AnatolyNevzoroff/SOLDERING_24V/FOTOBONUS/Front panel assembly 2.jpg

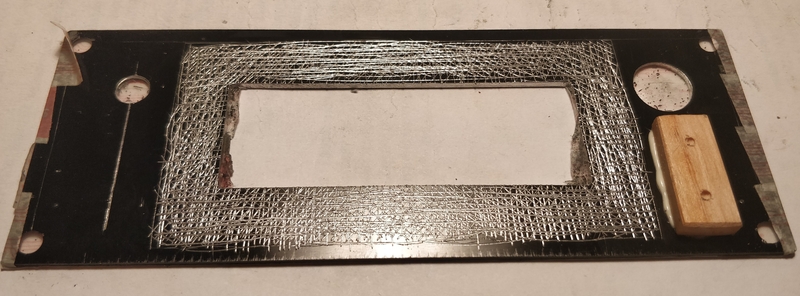
FOTOBONUS/Front panel assembly 2.jpg
