AnatolyNevzoroff/SOLDERING_24V/FOTOBONUS/Final result 1.jpg

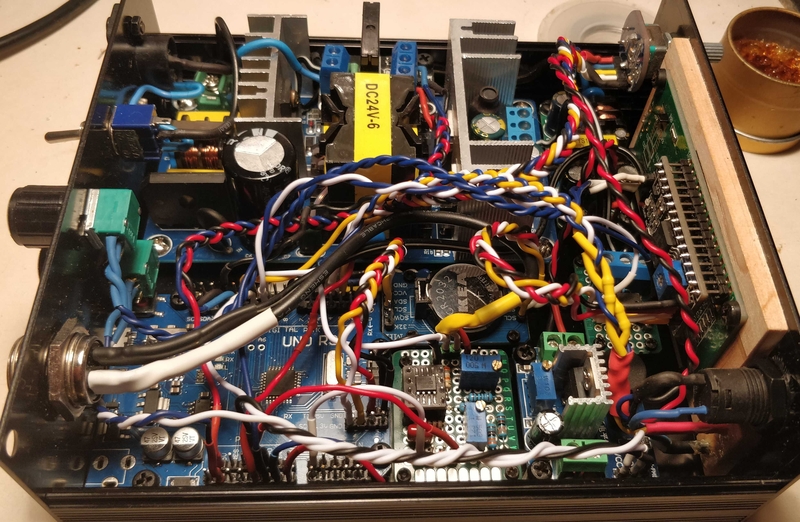
FOTOBONUS/Final result 1.jpg
