AnatolyNevzoroff/SOLDERING_24V/FOTOBONUS/We set up the amplifier, convert millivolts to degrees 1.jpg

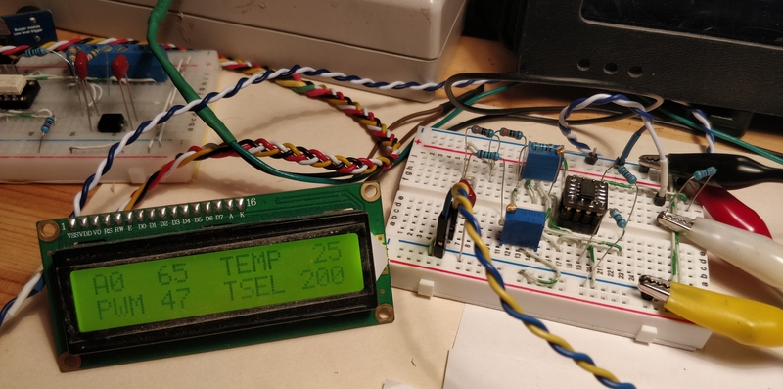
FOTOBONUS/We set up the amplifier, convert millivolts to degrees 1.jpg
