AnatolyNevzoroff/SOLDERING_24V/SCHEMES/Amplifier circuit for measuring the heating of a thermistor.jpg

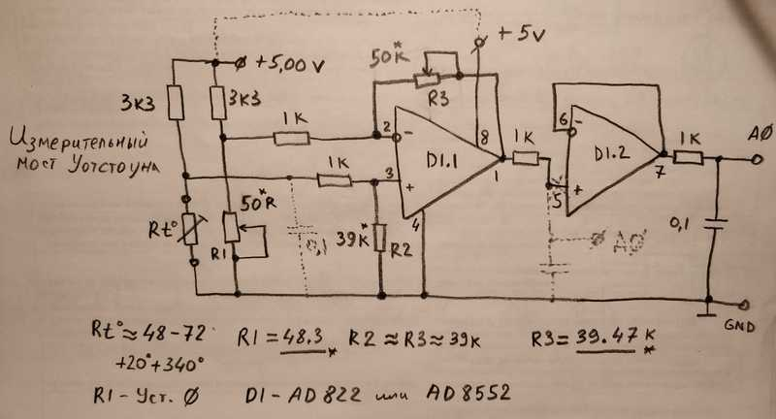
SCHEMES/Amplifier circuit for measuring the heating of a thermistor.jpg
