AnatolyNevzoroff/SOLDERING_24V/SCHEMES/LM317 voltage regulator circuit.jpg

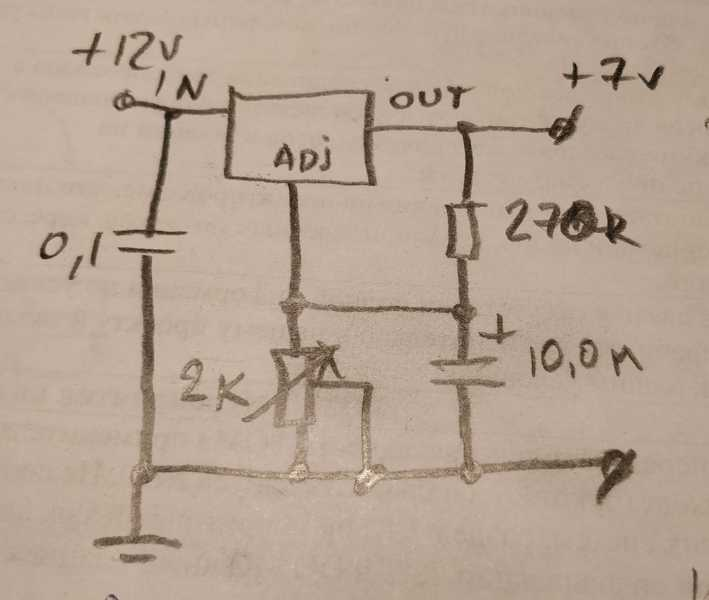
SCHEMES/LM317 voltage regulator circuit.jpg
