AnatolyNevzoroff/SOLDERING_24V/SCHEMES/Mosfet transistor switching circuit.jpg

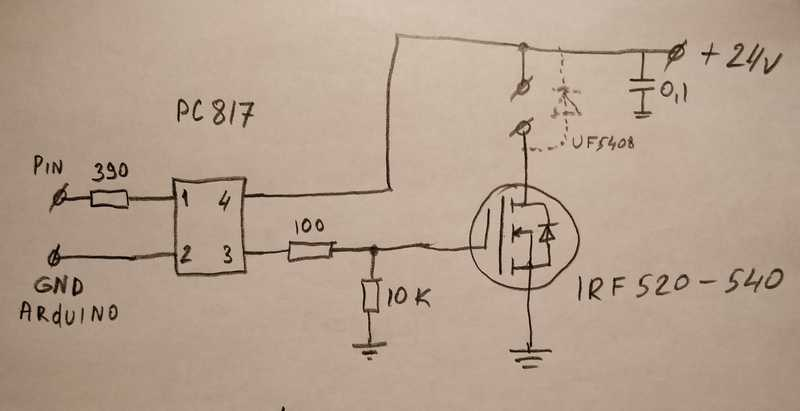
SCHEMES/Mosfet transistor switching circuit.jpg
