AnatolyNevzoroff/SOLDERING_24V/SCHEMES/Pinout for LM317.jpg

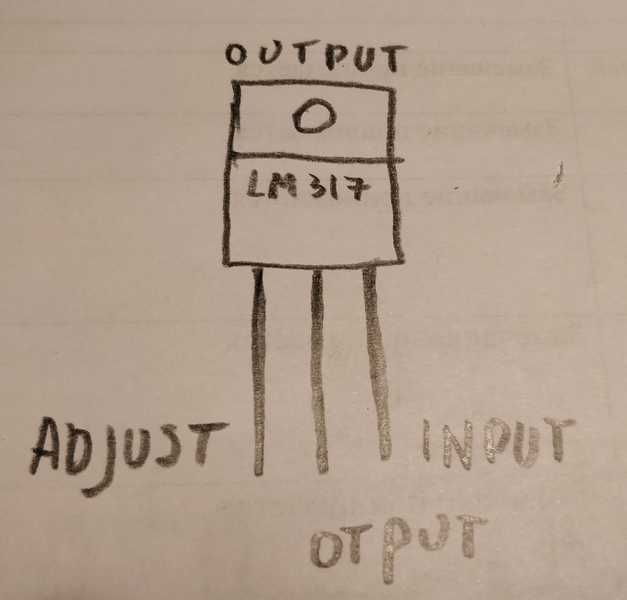
SCHEMES/Pinout for LM317.jpg
