AnatolyNevzoroff/SOLDERING_24V/FOTOBONUS/Front panel assembly 1.jpg

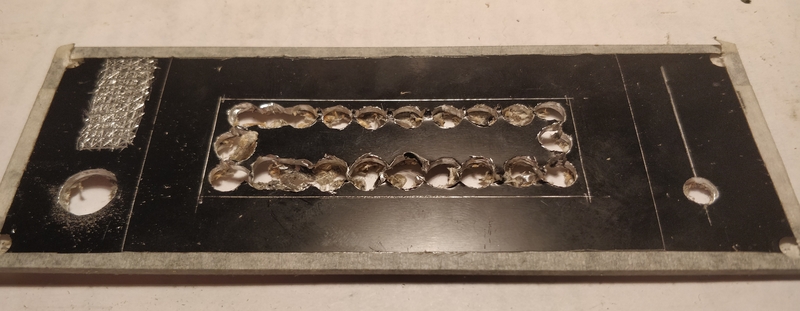
FOTOBONUS/Front panel assembly 1.jpg
