AnatolyNevzoroff/SOLDERING_24V/FOTOBONUS/Front panel assembly 3.jpg

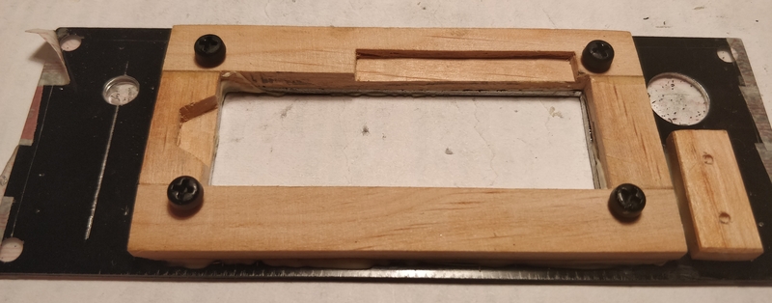
FOTOBONUS/Front panel assembly 3.jpg
