AnatolyNevzoroff/SOLDERING_24V/FOTOBONUS/Front panel assembly 4.jpg

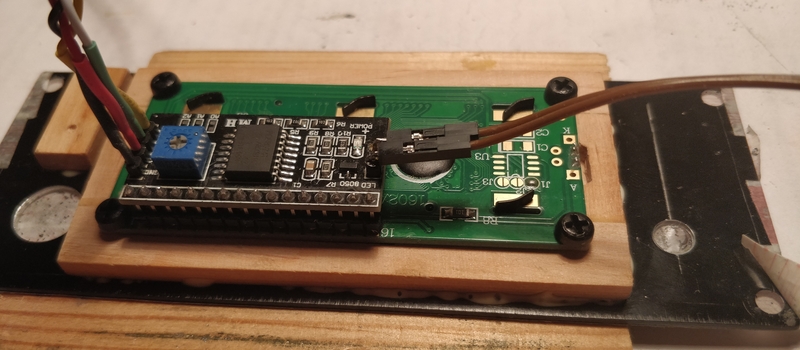
FOTOBONUS/Front panel assembly 4.jpg
