AnatolyNevzoroff/SOLDERING_24V/FOTOBONUS/Front panel assembly 5.jpg

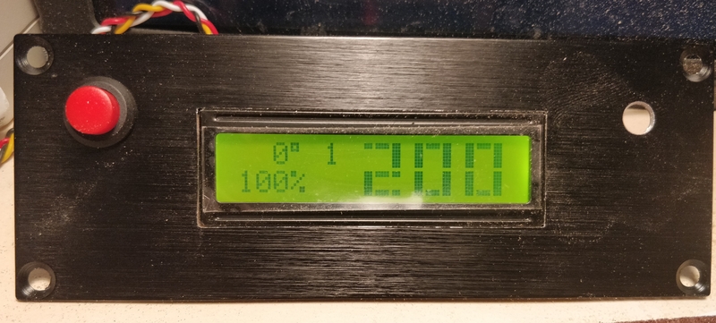
FOTOBONUS/Front panel assembly 5.jpg
