AnatolyNevzoroff/SOLDERING_24V/FOTOBONUS/We plan the layout in the building.jpg

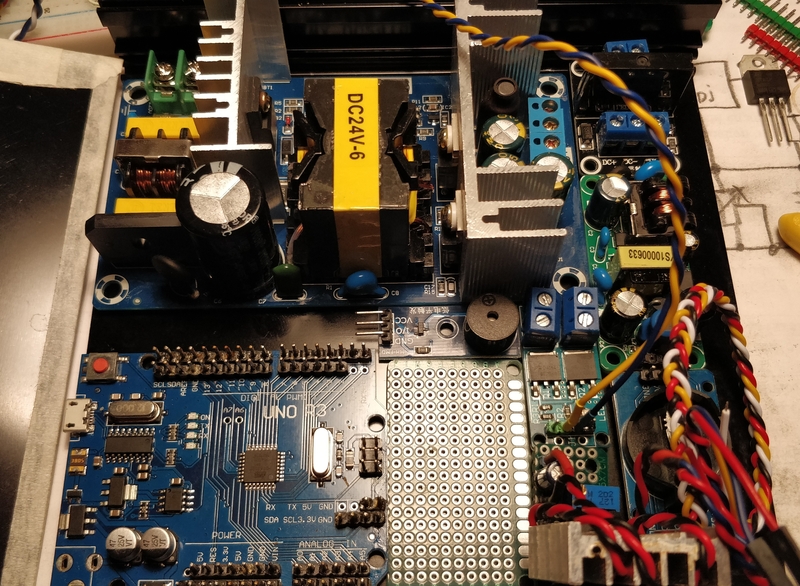
FOTOBONUS/We plan the layout in the building.jpg
