AnatolyNevzoroff/SOLDERING_24V/FOTOBONUS/Final result 2.jpg

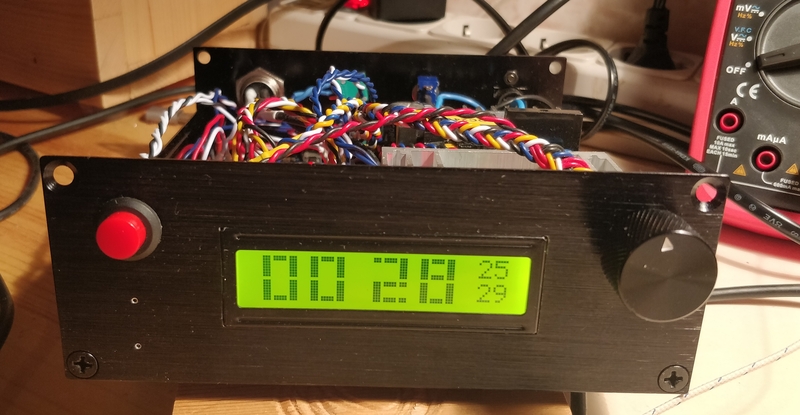
FOTOBONUS/Final result 2.jpg
