AnatolyNevzoroff/SOLDERING_24V/FOTOBONUS/Final result 3.jpg

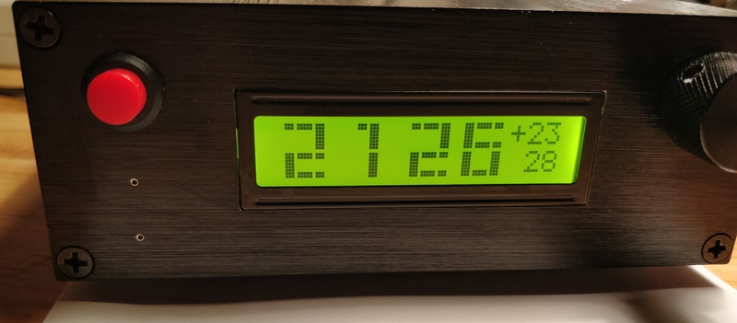
FOTOBONUS/Final result 3.jpg
