AnatolyNevzoroff/SOLDERING_24V/(threads)

Thread 1 (2023-11-29):

Encoder

44chsv, 2023-11-29:
У меня возникла проблема с энкодером. Всегда происходит изменение значения в одну сторону. В чем может быть проблема?

AnatolyNevzoroff, 2023-11-30:
Попробуйте проверить свой энкодер на простом примере в Arduino IDE
Файл -> Примеры -> Encoder -> Basic входящем в библиотеку.
Не забудьте указать выводы ардуино к которым вы подключили энкодер например:
Encoder myEnc(3, 4); здесь D3 и D4
Загрузите скетч в ардуино и посмотрите в мониторе порта как ведут себя
значения.
Если энкодер работает исправно проверьте правильно ли указаны выводы в
скетче паяльника и перезалейте софт. Если опять будет работать неправильно
напишите будем дальше искать проблему.

чт, 30 нояб. 2023 г. в 01:13, 44chsv ***@***.***>:

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

--

С уважением, *Невзоров Анатолий Юрьевич*.
 *+79882377098*

44chsv, 2023-11-30:
Спасибо за быстрый ответ.
Да, я так и сразу сделал. Попробовал: "Файл -> Примеры -> Encoder -> Basic входящем в библиотеку.
Не забудьте указать выводы ардуино к которым вы подключили энкодер например:
Encoder myEnc(3, 4); здесь D3 и D4"
В этом примере тоже также ведёт себя. т.е. в одну сторону прибавляются значения хорошо, а в другую практически значения не меняются.
Поэтому я усомнился в этой библиотеки и попробовал библиотеку от Александра Гавера EncButton.h
В примере этой библиотеки мой энкодер и кнопка работает чётко и исправно.
Далее, я заменил библиотеку Encoder.h в вашем коде, на EncButton.h
Вчера было поздно уже, но при проверке работы опять же при изменении температуры в главном меню
теперь при повороте в обе стороны температура только увеличивается.
Сейчас смотрю текст кода, возможно что-то упустил при смене библиотек.
И странно почему не работает пример из применённой вами библиотеки.
Не знаю, здесь удобно обсуждать мои проблемы в проекте? может удобнее на другой площадке и мессенджере?
Ещё раз благодарю за помощь.

44chsv, 2023-11-30:
и в следующих меню курсор бегает туда сюда как положено, а значения в любую сторону только увеличиваются.

AnatolyNevzoroff, 2023-11-30:
Попробуйте вот такой вариант скетча.

чт, 30 нояб. 2023 г. в 15:42, 44chsv ***@***.***>:

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

--

С уважением, *Невзоров Анатолий Юрьевич*.
 *+79882377098*

44chsv, 2023-12-01:
Здравствуйте,  Анатолий.

Ваш Емаил не отобразился. Попробую ответить так, на ваш гитхабовский адрес.
Когда появится другой энкодер, попробую ещё раз ту библиотеку.
Сейчас, с библиотекой от Гайвера, мне удалось добиться нормальной работы
энкодера.
Возможно вы будете смеяться, но я добавил в ваш проект вместо схемы
усилителя термопары на ОУ, модуль на MAX31855. Хороший ОУ ищу, а 358 не
хочется ставить.
Результат есть, работает, но требует доработки. Сначала подключал МАХ31855
на пины hard SPI работало хорошо.
Сейчас пришлось подключить на другие пины, так как в вашем варианте они
заняты.
Работает, но как-то не стабильно. Буду искать причину, возможно придётся
вернуть на пины хард SPI.
Вы не пробовали использовать такие модули?
Попробую пристегнуть файл, не знаю получите или нет.
Если у вас есть время посмотреть и указать на мои недочёты.
В программировании не силён, только учусь.
Вообще, от энкодера с удовольствием отказался бы, не нравится это
устройство.
Три или четыре кнопки для меня удобнее.

С уважением, Сергей.

пт, 1 дек. 2023 г. в 00:09, Anatoliy Nevzoroff ***@***.***>:

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

44chsv, 2023-12-01:
Похоже нет файла.

Thread 2 (2023-12-15):

//ПОКА ПАЯЛЬНИК ГОРЯЧИЙ МИГАЕМ ИНДИКАТОРОМ

44chsv, 2023-12-15:
В этом отрезке кода нужно изменить вывод пина с 10 на 12.
И при остывании будет мигать другой светодиод.

строка 454       //ПОКА ПАЯЛЬНИК ГОРЯЧИЙ МИГАЕМ ИНДИКАТОРОМ
.            if (f.w7 == true && mill - timer5 > (f.w6 ? p400 : p500)) {
.               timer5 = mill;
.               f.w6 = !f.w6;
строка 458        digitalWrite(10, f.w6);
            }
Иначе в режиме остывания мосфет будет открываться с частотой 1 Гц и паяльник не будет остывать.

AnatolyNevzoroff, 2023-12-15:
Не совсем так, на затвор силового мосфета действительно будет приходить 5В,
но это происходит в режиме Power OFF и силовой блок питания выключен через
твердотельное реле на симисторе, поэтому ТЭН не нагреется.
Сергей, лучше писать на tolik собака yandex точка ru

пт, 15 дек. 2023 г. в 19:55, Сергей Владимирович ***@***.***>:

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

--

С уважением, *Невзоров Анатолий Юрьевич*.
 *+79882377098*

44chsv, 2023-12-16:
Добрый день, Анатолий.
Сейчас все собрано навесным монтажом. ТЭН питается от +24 В через модуль
реле с оптронной развязкой. А мосфет подключен без оптронной развязки.
В общем при нажатии на кнопку вкл/выкл на дисплее отображается
предупреждение о горячем жале и начинает мигать светодиод, И в такт со
светодиодом открыватся мосфет, соответственно жало не остывает.
После того как изменил в коде, сейчас мигает другой светодиод (не так важно
какой мигает) и далее как было задумано остывает жало до установленной
температуры.
Конечно можно сделать коммутацию питания как у вас и обесточивать БП
полностью. Может у кого-то БП будет отдельно, тогда обесточить его будет не
просто.
Это в принципе это незначительные детали для тех кто понимает что к чему.
Вообще проект понравился, за это большое спасибо. А нашёл ваш проект по
наводке автора с сайта http://rcl-radio.ru . Код написан с подробными
комментариями, что очень важно для начинающий "кодописателей" как я :).
По поводу ручки паяльника, у меня такая же как в вашем видео, но в ней
реально термопара. Поэтому собрал таки усилитель термопары на ОУ 358.
Он немного отличается от вашей схемы. Позже возможно попробую более
качественные ОУ. Но и так работает вроде нормально.
С модулем на MAX31855 (MAX6675) пока не осилил переделать код, но оно
работало.
С энкодером пока без изменений, работает только на увеличение. Сейчас на
подходе посылка с Али с другим энкодером, попробую тогда видно будет.
Сейчас буду попробовать вместо Ардуино нано плату на LGT8F328P. Такие платы
понравились, немного попробовал с ними работать.
Наверно в коде придётся внести изменения для таймера.
//ПЕРЕВОДИМ ПИНЫ D9 и D10 ТАЙМЕРА №1 НА ЧАСТОТУ - 31.4 кГц
TCCR1A = 0b00000001;//8bit
TCCR1B = 0b00000001;//x1 phase correct
пока не знаю как, но есть хорошая помощь в этом здесь.
LGT8F328P timer
<https://dbuezas.github.io/arduino-web-timers/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>
Буду смотреть код из второй вашей версии паяльника 230 В.
Мне интересно управление мощностью в нагрузке циклическим режимом
регулирования.
Приобрёл простую медленноварку, хочу чтобы она работала по заданным режимам
температуры и времени.
Она сейчас работает с промышленным контроллером Autonics TC4М, но он только
поддерживает заданную температуру.

С уважением, Сергей.

сб, 16 дек. 2023 г. в 01:24, Anatoliy Nevzoroff ***@***.***>:

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
