AnatolyNevzoroff/SOLDERING_24V/SOLDERING_24V_VER.1.4/SOLDERING_24V_VER.1.4.ino

//////////////////////////////////// ПАЯЛЬНИК 24V ВЕРСИЯ 1.4 //////////////////////////////////////
///////////////////// СКЕТЧ АНАТОЛИЯ НЕВЗОРОВА // CODE BY ANATOLY NEVZOROFF ///////////////////////
//ДОПОЛНИТЕЛЬНАЯ ИНФОРМАЦИЯ НА YouTube КАНАЛЕ ПО АДРЕСУ: https://youtu.be/Rubw6RNYvhU

#define p60000 60000L
#define p1000 1000L //ИНТЕРВАЛ 1000 mS (1 СЕКУНДА), ТИП ДАННЫХ "L" (long)
#define p500 500L
#define p400 400L
#define p100 100L
//ИСКУССТВЕННАЯ ПАЗУЗА ДЛЯ ИНЖЕНЕРНОГО МЕНЮ. ЕСЛИ ТЭН ПЕРЕГРЕВАЕТСЯ - ЗНАЧЕНИЕ УВИЛИЧИТЬ ДО \
29L ИЛИ 30L ПРИ НЕДОСТАТОЧНОЙ МОЩНОСТИ ТЭН - УМЕНЬШИТЬ ДО 27L ИЛИ 26L
#define pause 28L
#define ledOFF lcd.noBacklight() //ОТКЛЮЧИТЬ ПОДСВЕТКУ ЭКРАНА
#define ledON lcd.backlight() //ВКЛЮЧИТЬ ПОДСВЕТКУ ЭКРАНА
#define hot 54 //БЕЗОПАСНАЯ ТЕМПЕРАТУРА ДЛЯ СМЕНЫ ЖАЛА (ОПРЕДЕЛЕНА ЭКСПЕРЕМЕНТАЛЬНО)
//ЕСЛИ МАКСИМАЛЬНЫЙ УРОВЕНЬ НА ВХОДЕ АЦП ДЛЯ АВАРИЙНОГО ОТКЛЮЧЕНИЯ = 1023 (питание 4,95 вольта) \
ТО maxADC ВЫБИРАЕМ НЕСКОЛЬКО МЕНЬШЕ НАПРИМЕР = 1022
#define maxADC 1022
    //#define SERIAL_PORT_ENABLE //ЗАКОМЕНТИРОВАТЬ ДЛЯ ОТКЛЮЧЕНИЯ СЕРИЙНОГО ПОРТА И ВЫВОДА ДАННЫХ

    /////////////////////////////////// ПОДКЛЮЧАЕМЫЕ БИБЛИОТЕКИ ///////////////////////////////////////
#include <EEPROM.h>//ЧТЕНИЕ И ЗАПИСЬ ПЕРЕМЕННЫХ В ЭНЕРГОНЕЗАВИСИМУЮ ПАМЯТЬ EEPROM
#include <Encoder.h>//ОБРАБОТКА УГЛА ПОВОРОТА ЭНКОДЕРА
#include <Wire.h>//ОБЕСПЕЧЕНИЕ ПЕРЕДАЧИ ДАННЫХ ПО ШИНЕ I2C (IIC) (ЭКРАН И ЧАСЫ)
#include <LiquidCrystal_I2C.h>//ПЕЧАТЬ СИМВОЛОВ НА ЖИДКОКРИСТАЛИЧЕСКОМ ЭКРАНЕ ЧЕРЕЗ I2C
#include <PID_v1.h>//https://github.com/br3ttb/Arduino-PID-Library \
БИБЛИОТЕКА ПРОПОРЦИОНАЛЬНО -ИНТЕГРАЛЬНОГО ДИФФЕРЕНЦИРОВАНИЯ ДЛЯ ИНЕРТНЫХ СИСТЕМ
#include <DS3231.h>//http://www.rinkydinkelectronics.com/download.php?f=DS3231.zip  МОДУЛЬ ЧАСОВ

    LiquidCrystal_I2C lcd(0x27, 16, 2); //УСТАНАВЛИВАЕМ АДРЕС, ЧИСЛО СИМВОЛОВ, СТРОК У ЖКИ ЭКРАНА
Encoder myEnc(3, 4); // DT и CLK ИЛИ S1 и S2 ВЫВОДЫ ЭНКОДЕРА
DS3231 rtc(SDA, SCL); Time wt; //ПОДКЛЮЧАЕМ МОДУЛЬ ЧАСОВ; ИНИЦИАЛИЗИРУЕМ ОБЪЕКТ wt ДЛЯ КЛАССА ЧАСОВ

/////////////////////////////////// ГЛОБАЛЬНЫЕ ПЕРЕМЕННЫЕ /////////////////////////////////////////

//unsigned long от 0 до 4294967295
uint32_t mill, timer1, timer2, timer3, timer4, timer5; //ТАЙМЕРЫ ДЛЯ ФУНКЦИИ millis()

//int от -32768 до 32767
int16_t pwm, inputdata, temp, temp0, temp1, temp2, tempwait, trig, trig2, graf, KpSet, KiSet, KdSet;
int16_t testtemp;
int16_t freq[4] = {1370, 1170, 970, 770}; //МАССИВ ДЛЯ ФУНКЦИИ tone()

//byte от 0 до 255
uint8_t temp00, temp01, temp10, temp11, temp20, temp21, ar, sharp, zen[3] = {1, 5, 10};
uint8_t led, str, KpSet10, KpSet11, KiSet10, KiSet11, KdSet10, KdSet11;
uint8_t poz[8] = {0, 3, 6, 14, 0, 3, 8, 15}; //МАССИВ ДЛЯ ПОЗИЦИОНИРОВАНИЯ КУРСОРА В МЕНЮ УСТАНОВКИ ВРЕМЕНИ

//char от -128 до 127
int8_t fr, m0, m1, om1, m2, m3, menu, wait, down, autoret, trig1, trig3, loc, oldPos, newPos;
int8_t setime, sethour, setmin, setsec, setdate, setmon, setyear, setdow;

//boolean от false до true
bool flag, btn5, oldbtn5, btn6, oldbtn6, btn7, oldbtn7, save, power;

//СТРУКТУРА ДЛЯ ЭКОНОМИИ ПАМЯТИ НА ФЛАГАХ
struct Flags {
  bool w0: 1, w1: 1, w2: 1, w3: 1, w4: 1, w5: 1, w6: 1, w7: 1, w8: 1, w9: 1;
}; Flags f;

double Setpoint;//ТРЕБУЕМАЯ ТЕМПЕРАТУРА
double Input;   //ДАННЫЕ О ТЕКУЩЕЙ ТЕМПЕРАТУРЕ
double Output;  //ШИМ СИГНАЛ С ЦИФРОВОГО ВЫХОДА
double Kp;      //АГРЕССИВНОСТЬ НАБОРА ТЕМПЕРАТУРЫ Setpoint, ЧЕМ БОЛЬШЕ ТЕМ БЫСТРЕЕ
double Ki;      //"ПРЕДСКАЗЫВАЕТ" ЗНАЧЕНИЕ Input, ЧЕМ БОЛЬШЕ ТЕМ ИНЕРЦИОННЕЕ
double Kd;    //УСРЕДНЯЕТ, СГЛАЖИВАЕТ Output ПРЕДОТВРАЩАЕТ КОЛЕБАНИЯ
PID myPID(&Input, &Output, &Setpoint, Kp, Ki, Kd, DIRECT);

//УКАЗЫВАЕМ ВСЕ ФУНКЦИИ ДЛЯ БОЛЕЕ БЫСТРОЙ КОМПИЛЯЦИИ, ДЛЯ ВЛАДЕЛЬЦЕВ МОЩНЫХ ПК НЕАКТУАЛЬНО
void menu0(); void menu1(); void menu2(); void digprint1(); void digprint2(); void digprint3();
void key5(); void bigdigit(); void bigdigit(); void bigdigitres(); void arrow0(); void arrow1();
void clmil(); void clful(); int16_t median(uint8_t samples); void bigtime(); void get_time();
void set_time();

//////////////////////////////////////////// SETUP ////////////////////////////////////////////////
void setup() {

  //ПЕРЕВОДИМ ПИНЫ D9 и D10 ТАЙМЕРА №1 НА ЧАСТОТУ - 31.4 кГц
  TCCR1A = 0b00000001;//8bit
  TCCR1B = 0b00000001;//x1 phase correct

  Wire.begin(); lcd.init(); myPID.SetMode(AUTOMATIC); myPID.SetOutputLimits(0, 255); rtc.begin();

  //pinMode(3,INPUT);       //ПОВОРОТ ЭНКОДЕРА ВЛЕВО
  //pinMode(4,INPUT);       //ПОВОРОТ ЭНКОДЕРА ВПРАВО
  pinMode(5, INPUT);      //КНОПКА ПОДМЕНЮ SUBMENU KEY (Кнопка SW энкодера)
  pinMode(6, INPUT_PULLUP); //КНОПКА ВКЛЮЧЕНИЯ POWER/STANDBY KEY
  pinMode(7, INPUT_PULLUP); //ВХОД ДЛЯ РТУТНОГО ДАТЧИКА
  pinMode(10, OUTPUT);    //ВЫХОД ДЛЯ ШИМ СИГНАЛА / LED INDICATOR (Оранжевый светодиод)
  pinMode(11, OUTPUT);    //ВЫХОД ДЛЯ ПЬЕЗОПИЩАЛКИ (tone() РАБОТАЕТ НА ПИНАХ 3 И 11 ВТОРОГО ТАЙМЕРА)
  pinMode(12, OUTPUT);    //ВЫХОД ДЛЯ ИНДИКАТОРА ВКЛЮЧЕНИЯ POWER LED ON/OFF (Красный светодиод)
  pinMode(13, OUTPUT);    //ВЫХОД ДЛЯ БЛОКА ПИТАНИЯ POWER RELAY ON/OFF ВКЛЮЧЕНО - LOW
  digitalWrite(13, HIGH); //ОТКЛЮЧАЕМ ПИТАНИЕ БП НА 24V или PORTB|=1<<5;
  analogReference(DEFAULT);//ВКЛЮЧАЕМ ВНУТРЕННЕЕ ОПОРНОЕ НАПРЯЖЕНИЕ 5,0 ВОЛЬТ (для 1,1 В INTERNAL)

  ////////////////////////////////// ЧИТАЕМ ПЕРЕМЕННЫЕ ИЗ EEPROM ////////////////////////////////////
  temp00 = EEPROM.read(0); temp01 = EEPROM.read(1); temp0 = word(temp00, temp01);
  temp10 = EEPROM.read(2); temp11 = EEPROM.read(3); temp1 = word(temp10, temp11);
  temp20 = EEPROM.read(4); temp21 = EEPROM.read(5); temp2 = word(temp20, temp21);
  tempwait = EEPROM.read(6); led = EEPROM.read(7); sharp = EEPROM.read(8);
  wait = EEPROM.read(9); down = EEPROM.read(10); autoret = EEPROM.read(11);
  //КОЭФФИЦИЕНТ ПРОПОРЦИОНАЛЬНОСТИ (0.00-9.99)
  KpSet10 = EEPROM.read(12); KpSet11 = EEPROM.read(13); KpSet = word(KpSet10, KpSet11);
  //КОЭФФИЦИЕНТ ИНТЕГРИРОВАНИЯ (0.00-9.99)
  KiSet10 = EEPROM.read(14); KiSet11 = EEPROM.read(15); KiSet = word(KiSet10, KiSet11);
  //КОЭФФИЦИЕНТ ДИФФЕРЕНЦИРОВАНЯ (0.00-9.99)
  KdSet10 = EEPROM.read(16); KdSet11 = EEPROM.read(17); KdSet = word(KdSet10, KdSet11);

  ///////////////////////////////////// В Н И М А Н И Е !!! ////////////////////////////////////////
  //ВО ИЗБЕЖАНИЕ "СТРАННОГО" ПОВЕДЕНИЯ ПАЯЛЬНИКА ПРИ САМОЙ ПЕРВОЙ ЗАГРУЗКИ СКЕТЧА: \
  1. РАСКОММЕНТИРУЙТЕ РЕКОМЕНДОВАННЫЕ ЗНАЧЕНИЯ ПЕРЕМЕННЫХ, СОХРАНЯЕМЫХ В ПАМЯТЬ \
  2. ЗАГРУЗИТЕ СКЕТЧ В МК \
  3. ВКЛЮЧИТЕ И ВЫКЛЮЧИТЕ ПАЯЛЬНИК КНОПКОЙ "POWER" (ПЕРЕЗАПИСАВ EEPROM) \
  4. ЗАКОМЕНТИРУЙТЕ РЕКОМЕНДОВАННЫЕ ПАРАМЕТРЫ И ПОВТОРНО ЗАГРУЗИТЕ СКЕТЧ В МК
  //РЕКОМЕНДОВАННЫЕ ПАРАМЕТРЫ
  //temp0=225;temp1=240;temp2=260;tempwait=120;led=1;sharp=5;wait=5;down=5;autoret=20; \
  KpSet = 240; KiSet = 80; KdSet = 0;

  //ЗАДАЁМ КОЭФФИЦИЕНТЫ ПИД ПОСЛЕ ОТКЛЮЧЕНИЯ ПИТАНИЯ
  Kp = (double)KpSet / 100.0; Ki = (double)KiSet / 100.0; Kd = (double)KdSet / 100.0;
  bigdigitres();//ЗАГРУЖАЕМ СИМВОЛЫ ПСЕВДОГРАФИКИ ДЛЯ БОЛЬШИХ ЦИФР
  f.w2 = true; //ДЛЯ НАЧАЛЬНОЙ РАЗОВОЙ ЗАГРУЗКИ ЗНАЧЕНИЙ В РЕЖИМЕ "POWER OFF"
#ifdef SERIAL_PORT_ENABLE
  Serial.begin(9600);
#endif

}//END SETUP


void loop() {

  //ЧТЕНИЕ ПОЛОЖЕНИЯ ЭНКОДЕРА И ПЕРЕЗАПИСЬ ПЕРЕМЕННОЙ mill
  newPos = myEnc.read() / 4; mill = millis();

  ///////////// КНОПКА ВКЛЮЧЕНИЯ POWER ON/OFF ЛОГИЧЕСКИЙ "0" НАЖАТА "1" НЕ НАЖАТА ////////////////
  //ХОРОШИЙ АЛГОРИТМ ДЛЯ ПЛОХИХ КНОПОК
  btn6 = digitalRead(6); if (btn6 != oldbtn6) {
    delay(40); btn6 = digitalRead(6);
    if (!btn6 && oldbtn6) {
      power = !power;
      f.w2 = true;
      clmil();
    } oldbtn6 = btn6;
  }

  //////////////////////////////////////////// POWER ON ////////////////////////////////////////////
  if (power == true) {
    //ЗАДАЁМ НАЧАЛЬНЫЕ ЗНАЧЕНИЯ ДЛЯ РЕЖИМА "POWER ON"
    if (f.w2 == true) {
      menu = 0; f.w0 = true; f.w1 = true; f.w2 = false; f.w4 = false; f.w5 = false; f.w7 = false; fr = 3;
      timer3 = mill; ledON; lcd.noCursor(); lcd.noBlink(); digitalWrite(12, HIGH); digitalWrite(13, LOW);
      lcd.clear();
    }

    //ПОДАЁМ ЗВУКОВОЙ СИГНАЛ ВКЛЮЧЕНИЯ СИЛОВОГО БЛОКА ПИТАНИЯ 24В
    if (fr > -1 && mill > timer3) {
      timer3 = mill + p100;
      tone(11, freq[fr], 90);
      fr--;
    }

    //КОНТРОЛЬ ДАТЧИКА ПОЛОЖЕНИЯ РУЧКИ ПАЯЛЬНИКА
    btn7 = digitalRead(7); if (btn7 != oldbtn7) {
      clmil();
      f.w0 = true;
      oldbtn7 = btn7;
    }

    //ВХОД В МЕНЮ 1 ИЛИ 2
    if (f.w4 == true && oldbtn5 == LOW && mill - timer1 > p400) {
      timer1 = mill; ++menu;
      if (menu > 2) {
        menu = 0;
      } f.w1 = true; f.w4 = false; f.w5 = true; lcd.clear();
    }

    ///////////////////////////////////////// ЯДРО ПАЯЛЬНИКА /////////////////////////////////////////
    inputdata = median(15); //ЧИТАЕМ ОТФИЛЬТРОВАННЫЕ СРЕДНЕ-МЕДИАННЫЕ (1 ИЗ 15) ЗНАЧЕНИЯ С ПОРТА "А0"

    //МИНИМАЛЬНАЯ ЗАЩИТА ОТ ПЕРЕГРЕВА, ТЕРМОРЕЗИСТОР ПОВРЕЖДЁН, ОБРЫВ КАБЕЛЯ, ПЛОХОЙ КОНТАКТ И Т.Д.
    //ПРОВЕРЯЕМ ЗНАЧЕНИЯ С ПОРТА "А0" НА ЗАВЕДОМО ЗАВЫШЕННЫЕ
    if (inputdata > maxADC) {
      digitalWrite(13, HIGH); lcd.clear();
      lcd.setCursor(0, 0); lcd.print(F("SOLDERING IRON")); lcd.setCursor(5, 1); lcd.print(F("ERROR!"));
      delay(2000); power = false; f.w2 = true;
    }

    Input = map(inputdata, 0, maxADC, 20, 350); //ПЕРЕВОДИМ ПОЛУЧЕННЫЕ С АЦП ЗНАЧЕНИЯ В ТЕМПЕРАТУРУ
    Setpoint = temp; //ОТСЫЛАЕМ ЗАДАННУЮ ТЕМПЕРАТУРУ В ПИД
    myPID.SetTunings(Kp, Ki, Kd); //УСТАНАВЛИВАЕМ КОЭФФИЦИЕНТЫ ПИД
    myPID.Compute();//ПРОПОРЦИОНАЛЬНО-ИНТЕГРАЛЬНОЕ ДИФФЕРЕНЦИРОВАНИЕ ТЕМПЕРАТУРЫ (ПИД)
    analogWrite(10, Output); //РЕЗУЛЬТАТ РАБОТЫ ПИД ПРЕОБРАЗУЕМ В ШИМ

#ifdef SERIAL_PORT_ENABLE
    Serial.print("Kp "); Serial.print(Kp, 2); Serial.print(" ");
    Serial.print("KpSet "); Serial.println(KpSet);
    Serial.print("Ki "); Serial.print(Ki, 3); Serial.print(" ");
    Serial.print("KiSet "); Serial.println(KiSet);
    Serial.print("Kd "); Serial.print(Kd, 2); Serial.print(" ");
    Serial.print("KdSet "); Serial.println(KdSet);
#endif

    /////////////////////////////////////////// ГЛАВНОЕ МЕНЮ /////////////////////////////////////////
    if (menu == 0) {
      if (f.w5 == true) {
        f.w5 = false;
        arrow0();
        clmil();
      }

      btn5 = digitalRead(5); if (btn5 != oldbtn5) {
        delay(10); btn5 = digitalRead(5);
        if (btn5 == LOW && oldbtn5 == HIGH) {
          timer1 = mill;
          ++m0;
          if (m0 > 2) {
            m0 = 0;
          } f.w0 = true;
          f.w4 = true;
        } oldbtn5 = btn5;
      }
      //ЗДЕСЬ РЕАЛИЗОВАНА ВОЗМОЖНОСТИ ПЕРЕПРЫГНУТЬ ЧЕРЕЗ ЗНАЧЕНИЕ РЕЖИМА ТЕМПЕРАТУРЫ, \
      НАПРИМЕР С Т1 НА Т3 ИЛИ С Т3 НА Т2, ГЛАВНОЕ УСПЕТЬ НАЖАТЬ ДВАЖДЫ В ТЕЧЕНИЕ 500 МС \
      НЕ ВОЛНЙТЕСЬ, ЗА 0, 5 СЕКУНДЫ МОЖНО И 3 РАЗА НАЖАТЬ, ТЕМПЕРАТУРНЫЙ РЕЖИМ ПЕРЕПРЫГНЕТ ДВАЖДЫ И \
      ФАКТИЧЕСКИ НЕ ИЗМЕНИТЬСЯ, МОЖЕТЕ ПРОВЕРИТЬ : -)) \
      А ЕСЛИ НАЖАТЬ И НЕ ОТПУСКАТЬ КНОПКУ БОЛЕЕ 400 МС. (ЧТО САМО ПО СЕБЕ ДОВОЛЬНО БЫСТРО И \
      НАСТУПАЕТ РАНЬШЕ НА 100 МС ЧЕМ ИЗМЕНЕНИЕ РЕЖИМА ТЕМПЕРАТУРЫ) КОМАНДА СМЕНЫ РЕЖИМА НЕ УСПЕВАЕТ \
      ОТОБРАЗИТЬСЯ, ПРОИСХОДИТ ПЕРЕХОД В МЕНЮ НАСТРОЙКИ, НО ФАКТИЧЕСКИ ТЕМПЕРАТУРНЫЙ РЕЖИМ \
      МЕНЯЕТСЯ НА ЕДИНИЦУ, ПОЭТОМУ МИНУСУЕМ ЕГО УЖЕ В МЕНЮ НАСТРОЙКИ.
      if (f.w4 == true && mill - timer1 > p500) {
      f.w4 = false;
      clmil();
      }

      //МЕНЯЕМ ТЕМПЕРАТУРУ В ЗАВИСИМОСТИ ОТ ВЫБРАННОГО РЕЖИМА ТЕМПЕРАТУРЫ Т1, Т2, Т3
      if (newPos != oldPos) {
      trig = trig + (newPos * sharp); trig = constrain(trig, 150, 340); f.w0 = true; clful();
        switch (m0) {
          case 0: temp0 = trig; break;
          case 1: temp1 = trig; break;
          case 2: temp2 = trig; break;
        }
      }

      //ВЫВОДИМ НА ЭКРАН НОМЕР РЕЖИМА ТЕМПЕРАТУРЫ, ЗАДАННУЮ ТЕМПЕРАТУРУ (БОЛЬШИЕ ЦИФРЫ) \
      ВКЛЮЧАЕМ ИНДИКАТОР "POWER", ПОДАЁМ ЗВУКОВОЙ СИГНАЛ ЕСЛИ ВЫВОДИМ ПАЯЛЬНИК ИЗ СНА ОТ ДАТЧИКА
      if (f.w1 == true) {
      menu0(); bigdigit(); f.w1 = false; if (f.w7 == true) {
          f.w7 = false; tone(11, 1500, 300);
          digitalWrite(12, HIGH);
        }
      }
      //КАЖДЫЕ 0.5 СЕКУНДЫ
      if (mill - timer5 > p500) {
      timer5 = mill;
      //ОТОБРАЖАЕМ ФАКТИЧЕСКУЮ ТЕМПЕРАТУРУ
      lcd.setCursor(0, 0); graf = Input; digprint3(); lcd.write(B11011111);
        //ОТОБРАЖАЕМ СКВАЖНОСТЬ ШИМ В ПРОЦЕНТАХ (ДЛЯ АНТУРАЖА)
        pwm = map(Output, 0, 255, 0, 100); lcd.setCursor(0, 1); graf = pwm; digprint3(); lcd.print("% ");
        //ОТОБРАЖАЕМ ТЕМПЕРАТУРУ ВНУТРИ КОРПУСА
        lcd.print(rtc.getTemp(), 0);
      }
    }//END MENU 0

    /////////////////////////////////////////// МЕНЮ № 1 /////////////////////////////////////////////
    //НАСТРАИВАЕМЫЕ ПАРАМЕТРЫ: \
    1. WAIT - СКОЛЬКО МИНУТ ЖДАТЬ ПРИ ОТСУТСТВИИ АКТИВНОСТИ (НЕ СРАБАТЫВАЕТ ДАТЧИК ПОЛОЖЕНИЯ В РУЧКЕ \
    ПАЯЛЬНИКА, НЕТ ОБРАЩЕНИЯ К НАСТРОЙКАМ) ДО ПЕРЕХОДА В РЕЖИМ ОЖИДАНИЯ ИЛИ "СПЯЩИЙ РЕЖИМ". \
    ДИАПАЗОН ЗНАЧЕНИЙ 1 ... 99 (МИНУТ) \
    2. DOWN - СКОЛЬКО МИНУТ ЖДАТЬ ПРИ ОТСУТСТВИИ АКТИВНОСТИ В РЕЖИМЕ ОЖИДАНИЯ ДО ПОЛНОГО ОТКЮЧЕНИЯ. \
    ПАЯЛЬНИКА. ДИАПАЗОН ЗНАЧЕНИЙ 1 ... 99 (МИНУТ) \
    3. TMPW - ТЕМПЕРАТУРА ПОДДЕРЖИВАЕМАЯ ПАЯЛЬНИКОМ В РЕЖИМЕ ОЖИДАНИЯ. \
    ДИАПАЗОН ЗНАЧЕНИЙ 80 ... 150 (ГРАДУСОВ)\
    4. TS - ШАГ НАСТРОЙКИ ТЕМПЕРАТУРЫ В ГЛАВНОМ МЕНЮ. ВОЗМОЖНЫЕ ЗНАЧЕНИЯ 1, 5, 10 (ГРАДУСОВ)

    if (menu == 1) {
      if (f.w5 == true) {
        arrow1();
        f.w5 = false;
        f.w6 = true;
        ar = uint8_t(8);
        --m0;
        if (m0 < 0) {
          m0 = 2;
        }
      }
      key5();
      if (f.w6 == true && newPos != oldPos) {
        om1 = m1;
        m1 = m1 + newPos;
        if (m1 > 3) {
          m1 = 0;
        } if (m1 < 0) {
          m1 = 3;
        } clful();
      }
      if (f.w6 == false && newPos != oldPos) {
        trig1 = trig1 + newPos; clful();
        switch (m1) {
          case 0: wait = constrain(trig1, 1, 99); break;
          case 1: down = constrain(trig1, 1, 99); break;
          case 2: tempwait = constrain(trig1, 80, 150); break;
          case 3: if (trig1 > 2) {
              trig1 = 0;
            } if (trig1 < 0) {
              trig1 = 2;
            }; sharp = zen[trig1]; break;
        }
      }
      if (f.w1 == true) {
        menu1();
        f.w1 = false;
      }
    }//END MENU 1

    /////////////////////////////////////////// МЕНЮ № 2 /////////////////////////////////////////////
    //НАСТРАИВАЕМЫЕ ПАРАМЕТРЫ: \
    1. P = - КОЭФФИЦИЕНТ ПРОПОРЦИОНАЛЬНОСТИ. ДИАПАЗОН ЗНАЧЕНИЙ 0.00 - 9.99 (РЕКОМЕНДОВАНО 2.4) \
    2. I = - КОЭФФИЦИЕНТ ИНТЕГРИРОВАНИЯ. ДИАПАЗОН ЗНАЧЕНИЙ 0.00 - 9.99 (РЕКОМЕНДОВАНО 0.02) \
    3. D = - КОЭФФИЦИЕНТ ДИФФЕРЕНЦИРОВАНЯ. ДИАПАЗОН ЗНАЧЕНИЙ 0.00 - 9.99 (РЕКОМЕНДОВАНО 0.00) \
    4. RET - ЧЕРЕЗ СКОЛЬКО СЕКУНД АВТОМАТИЧЕСКИ ВЫХОДИТЬ ИЗ МЕНЮ НАСТРОЕК В ГЛАВНОЕ МЕНЮ ПОСЛЕ \
    ПОСЛЕДНЕГО ДЕЙСТВИЯ. ДИАПАЗОН ЗНАЧЕНИЙ 3 ... 30 (СЕКУНД)

    if (menu == 2) {
      if (f.w5 == true) {
        f.w5 = false;
        f.w6 = true;
        ar = uint8_t(8);
      }
      key5();
      if (f.w6 == true && newPos != oldPos) {
        m2 += newPos;
        if (m2 > 3) {
          m2 = 0;
        } if (m2 < 0) {
          m2 = 3;
        } clful();
      }
      if (f.w6 == false && newPos != oldPos) {
        trig2 += newPos; clful();
        switch (m2) {
          case 0: KpSet = constrain(trig2, 0, 999); break;
          case 1: KiSet = constrain(trig2, 0, 999); break;
          case 2: KdSet = constrain(trig2, 0, 999); break;
          case 3: autoret = constrain(trig2, 3, 30); break;
        }
      }
      if (f.w1 == true) {
        menu2();
        f.w1 = false;
      }
    }

    //ЕСЛИ НЕТ АКТИВНОСТИ В ЗАДАННЫЙ ИНТЕРВАЛ УХОДИМ В "СПЯЩИЙ РЕЖИМ" \
    ВЫВОДИМ ТЕМПЕРАТУРУ ПОДОГРЕВА ВО ВРЕМЯ СНА, СИМВОЛ РЕЖИМА 'W' И ЗВУКОВОЙ СИГНАЛ
    if (f.w0 == true && mill - timer1 > (wait * p60000)) {
      timer1 = mill; temp = tempwait; f.w0 = false; f.w7 = true;
      lcd.setCursor(5, 0); lcd.print('W'); tone(11, 900, 300); bigdigit();
    }
    //В "СПЯЩЕМ РЕЖИМЕ"
    if (f.w7 == true) {
      //МИГАЕМ ИНДИКАТОРОМ "POWER"
      if (mill - timer3 > (f.w8 ? p1000 : p400)) {
        timer3 = mill;
        f.w8 = !f.w8;
        digitalWrite(12, f.w8);
      }
      //ЕСЛИ В ЗАДАННЫЙ ИНТЕРВАЛ ПО ПРЕЖНЕМУ НЕТ АКТИВНОСТИ, ПЕРЕХОДИМ В РЕЖИМ "POWER OFF"
      if (mill - timer1 > (down * p60000)) {
        power = 0;
        f.w2 = true;
        f.w7 = false;
      }
    }

    /////////////////////////// АВТОВОЗВРАТ В ГЛАВНОЕ МЕНЮ ИЗ МЕНЮ 1 ИЛИ 2 ///////////////////////////
    if (menu != 0 && mill - timer1 > (autoret * p1000)) {
      menu = 0;
      f.w5 = true;
      lcd.clear();
    }

  }//END POWER ON

  ///////////////////////////////////// POWER OFF (STANDBY) ////////////////////////////////////////
  if (power == false) {
    //ЗАДАЁМ НАЧАЛЬНЫЕ ЗНАЧЕНИЯ ДЛЯ РЕЖИМА "POWER OFF"
    if (f.w2 == true) {
      menu = 0; fr = 0; save = true; f.w2 = false; f.w3 = false; f.w5 = true; f.w8 = true; arrow0();
      lcd.clear();
    }

    //ПОДАЁМ ЗВУКОВОЙ СИГНАЛ ОТКЛЮЧЕНИЯ ПАЯЛЬНИКА (БЛОКА ПИТАНИЯ 24В)
    if (fr < 5 && mill > timer4 + p100) {
      timer4 = mill;
      tone(11, freq[fr], 90);
      ++fr;
    }

    //ПЕРЕКЛЮЧЕНИЕ МЕЖДУ ГЛАВНЫМ МЕНЮ И МЕНЮ УСТАНОВКИ ВРЕМЕНИ
    if (f.w4 == true && oldbtn5 == LOW && mill - timer1 > p400) {
      timer1 = mill; ++menu;
      if (menu > 1) {
        menu = 0;
      } f.w3 = true; f.w4 = false; f.w5 = true; lcd.clear();
    }

    //ПЕРЕХОД В ТЕХНИЧЕСКОЕ МЕНЮ НАСТРОЙКИ
    if (f.w3 == true && oldbtn5 == LOW && mill - timer1 > p1000 + p1000) {
      timer1 = mill; f.w3 = false; f.w5 = true; menu = 2; lcd.clear();
    }

    ///////////////////////////// ГЛАВНОЕ МЕНЮ В РЕЖИМЕ "POWER OFF" /////////////////////////////////
    if (menu == 0) {
      //СБРАСЫВАЕМ МИГАНИЕ И ПОДЧЁРКИВАНИЕ КУРСОРА, ОТКЛЮЧАЕМ СИЛОВОЙ БП, ГАСИМ "LED POWER"
      if (f.w5 == true) {
        f.w5 = false; f.w7 = false; lcd.noCursor(); lcd.noBlink(); f.w4 = false;
        analogWrite(10, 0); digitalWrite(13, HIGH); digitalWrite(12, LOW);
      }

      //ОБРАБАТЫВАЕМ НАЖАТИЕ НА ЭНКОДЕР
      btn5 = digitalRead(5); if (btn5 != oldbtn5) {
        delay(10); btn5 = digitalRead(5);
        if (btn5 == LOW && oldbtn5 == HIGH) {
          timer1 = mill;
          f.w4 = true;
        } oldbtn5 = btn5;
      }

      //ПЕРЕКЛЮЧАЕМ ПОДСВЕТКУ ЭКРАНА КРАТКОВРЕМЕННЫМ НАЖАТИЕМ НА ЭНКОДЕР
      if (f.w4 == true && mill - timer1 > p500) {
        timer1 = mill;
        led = !led;
        (led ? ledON : ledOFF);
        f.w4 = false;
      }

      //СЧИТЫВАЕМ ТЕКУЩУЮ ТЕМПЕРАТУРУ ПАЯЛЬНИКА 1 РАЗ В СЕКУНДУ (ПРИ ОСТЫВАНИИ ДОСТАТОЧНО)
      if (f.w8 == true && mill > timer2 + p1000) {
        timer2 = mill; inputdata = median(15);
        temp = map(inputdata, 0, maxADC, 20, 350);
        //ЕСЛИ ПАЯЛЬНИК ГОРЯЧИЙ, ВЫВОДИМ ПРЕДУПРЕЖДАЮЩУЮ НАДПИСЬ И ТЕКУЩУЮ ТЕМПЕРАТУРУ
        if (temp > hot) {
          lcd.setCursor(0, 0); lcd.print("TIP IS"); lcd.setCursor(0, 1); lcd.print("HOT!!!");
          bigdigit(); ledON; f.w7 = true;
        }
        //ЕСЛИ ПАЯЛЬНИК ОСТЫЛ, УПРАВЛЯЕМ ПОДСВЕТКОЙ ЭКРАНА, ПОДАЁМ ЗВУКОВОЙ СИГНАЛ И ОТКЛЮЧАЕМ ИНДИКАТОР
        else if (f.w7 = true) {
          (led ? ledON : ledOFF); f.w7 = false; f.w8 = false; tone(11, 1300, 350);
          digitalWrite(10, LOW); lcd.clear();
        }
      }

      //ПОКА ПАЯЛЬНИК ГОРЯЧИЙ МИГАЕМ ИНДИКАТОРОМ
      if (f.w7 == true && mill - timer5 > (f.w6 ? p400 : p500)) {
        timer5 = mill;
        f.w6 = !f.w6;
        digitalWrite(10, f.w6);
      }

      //ЕСЛИ ПАЯЛЬНИК ХОЛОДНЫЙ ВЫВОДИМ ЧАСЫ И ТЕМПЕРАТУРУ ПАЯЛЬНИКА 1 РАЗ В СЕКУНДУ
      if (f.w8 == false && mill - timer3 > p1000) {
        timer3 = mill; inputdata = median(15);
        temp = map(inputdata, 0, maxADC, 20, 350); bigtime(); lcd.setCursor(13, 0); lcd.print('+'); lcd.print(temp);
      }
    }//END MENU 0

    ///////////////////////////////// МЕНЮ УСТАНОВКИ ВРЕМЕНИ И ДАТЫ //////////////////////////////
    if (menu == 1) {
      //СЧИТЫВАЕМ И ПЕЧАТАЕМ ТЕКУЩИЕ ЗНАЧЕНИЯ ВРЕМЕНИ И ДАТЫ
      if (f.w5 == true) {
        f.w5 = false; f.w6 = true; setime = 0; clmil(); get_time(); ledON;
        lcd.setCursor(0, 0); lcd.print(rtc.getTimeStr());
        lcd.setCursor(9, 0); lcd.print("SAVE-0+");
        lcd.setCursor(0, 1); lcd.print(rtc.getDateStr());
        lcd.setCursor(11, 1); lcd.print("DAY "); lcd.print(wt.dow);
        lcd.setCursor(poz[loc], str); lcd.blink();
      }
      //КНОПКОЙ ЭНКОДЕРА МЕНЯЕМ МИГАНИЕ НА ПОДЧЁРКИВАНИЕ КУРСОРА
      btn5 = digitalRead(5); if (btn5 != oldbtn5) {
        delay(10); btn5 = digitalRead(5);
        if (btn5 == LOW && oldbtn5 == HIGH) {
          clmil(); f.w4 = true; f.w6 = !f.w6;
          if (f.w6 == true) {
            lcd.blink();
            lcd.noCursor();
          } else {
            lcd.noBlink();
            lcd.cursor();
          }
        } oldbtn5 = btn5;
      }
      //ПОВОРОТОМ ЭНКОДЕРА МЕНЯЕМ ПОЗИЦИЮ КУРСОРА
      if (f.w6 == true && newPos != oldPos) {
        loc += newPos;
        if (loc < 0) {
          loc = 7;
          str = 1;
        } if (loc > 7) {
          loc = 0;
          str = 0;
        } if (loc > 3) {
          str = 1;
        } if (loc < 4) {
          str = 0;
        } clful();
      }
      //ПОВОРОТОМ ЭНКОДЕРА МЕНЯЕМ ЗНАЧЕНИЕ В ПОЗИЦИИ КУРСОРА
      if (f.w6 == false && newPos != oldPos) {
        trig3 += newPos; clful();
        switch (loc) {
          case 0: sethour = constrain(trig3, 0, 23); break;
          case 1: setmin = constrain(trig3, 0, 59); break;
          case 2: setsec = constrain(trig3, 0, 59); break;
          case 3: setime = constrain(trig3, -1, 1); break;
          case 4: setdate = constrain(trig3, 1, 31); break;
          case 5: setmon = constrain(trig3, 1, 12); break;
          case 6: setyear = constrain(trig3, 20, 99); break;
          case 7: setdow = constrain(trig3, 1, 7); break;
        }
      }
      if (f.w1 == true) {
        switch (loc) {
          case 0: trig3 = sethour; break;
          case 1: trig3 = setmin; break;
          case 2: trig3 = setsec; break;
          case 3: trig3 = setime; break;
          case 4: trig3 = setdate; break;
          case 5: trig3 = setmon; break;
          case 6: trig3 = setyear; break;
          case 7: trig3 = setdow; break;
        }
        lcd.setCursor(poz[loc], str); if (trig3 < 10 && loc != 3 && loc != 7) {
          lcd.print('0');
        }
        lcd.print(trig3); lcd.setCursor(poz[loc], str);
        //ЗАПИСЫВАЕМ ТЕКУЩИЕ ЗНАЧЕНИЯ ВРЕМЕНИ И ДАТЫ, ВЫВОДИМ СООБЩЕНИЕ ОБ ЭТОМ
        if (setime != 0) {
          set_time();
          lcd.clear();
          lcd.print(F("TIME & DATE SAVE"));
        }
        f.w1 = false;
      }
      //ВОЗВРАЩАЕМСЯ В ОСНОВНОЕ МЕНЮ
      if (setime != 0 && mill - timer1 > (p1000 + p1000)) {
        f.w5 = true;
        menu = 0;
        lcd.clear();
      }
    }//END MENU 1

    //////////////////////////// ТЕХНИЧЕСКОЕ МЕНЮ НАСТРОЙКИ ТЕМПЕРАТУРЫ //////////////////////////////
    //ДЛЯ НАСТРОЙКИ УСИЛИТЕЛЯ НАПРЯЖЕНИЯ ЗАМЕРЯЕМОГО МОСТОМ УИТСТОНА (Wheatstone bridge) \
    НАГРЕВАЕМ ТЭН ДО ЛЮБОЙ ОТНОСИТЕЛЬНО СТАБИЛЬНО УДЕРЖИВАЕМОЙ ТЕМПЕРАТУРЫ И ПОДСТРОЕЧНЫМИ \
    РЕЗИСТОРАМИ УСТАНАВЛИВАЕМ СООТВЕТСТВИЕ МЕЖДУ ОТОБРАЖАЕМОЙ И ЗАМЕРЯЕМОЙ ВНЕШНИМ ТЕРМОМЕТРОМ \
    КРОМЕ ТОГО, ПРИ ОТКЛЮЧЕНИИ РУЧКИ ОТ ПАЯЛЬНИКА ПОЛУЧАЕМ МАКСИМАЛЬНОЕ ЗНАЧЕНИЕ ПОЛУЧАЕМОЕ \
    С АЦП (ЭТО ЗНАЧЕНИЕ ЗАВИСИТ ОТ ПИТАНИЯ МК ИЛИ ОПОРНОГО НАПРЯЖЕНИЯ И НЕ ВСЕГДА РОВНО 5 ВОЛЬТ...) \

    if (menu == 2) {
      //СБРАСЫВАЕМ МИГАНИЕ И ПОДЧЁРКИВАНИЕ КУРСОРА, ЗАЖИГАЕМ "LED POWER", ВКЛЮЧАЕМ СИЛОВОЙ БП
      if (f.w5 == true) {
        f.w5 = false; lcd.noCursor(); lcd.noBlink(); pwm = 0;
        digitalWrite(12, HIGH); digitalWrite(13, LOW);
        lcd.setCursor(0, 0); lcd.print(F("PWM"));
        lcd.setCursor(8, 0); lcd.print(F("TEMP"));
        lcd.setCursor(0, 1); lcd.print(F("ADC RESULT"));
      }

      //ДЛЯ НАСТРОЙКИ ТЕМПЕРАТУРЫ ПОЛУЧАЕМОЙ С ТЕРМОРЕЗИСТОРА НАПРЯМУЮ УПРАВЛЯЕМ МОЩНОСТЬЮ ТЭН \
      МЕНЯЯ СКВАЖНОСТЬ ШИМ (В ОЧЕНЬ УЗКОМ ДИАПАЗОНЕ ТЕМПЕРАТУР!)
      if (newPos != oldPos) {
        pwm += newPos; myEnc.write(0); oldPos = 0; newPos = 0; timer2 = timer2 - p500;
        pwm = constrain(pwm, 0, 255);
      }
      //ВЫЧИСЛЯЕМ ТЕМПЕРАТУРУ
      inputdata = median(15); testtemp = map(inputdata, 0, maxADC, 20, 350);

      //РЕГУЛИРУЯ ТЕМПЕРАТУРУ ТОЛЬКО СКВАЖНОСТЬЮ ШИМ НЕВОЗМОЖНО БАЛАНСИРОВАТЬ НА ОПРЕДЕЛЁННОЙ \
      ТЕМПЕРАТУРЕ, ИЗМЕНЕНИЕ СКВАЖНОСТИ В НАЧАЛЕ ШКАЛЫ ПРИВОДИТ К ОЧЕНЬ РЕЗКИМ ПЕРЕПАДАМ ТЕМПЕРАТУРЫ \
      НАПРИМЕР ПРИ СКВАЖНОСТИ 5 ТЕМПЕРАТУРА НЕ БУДЕТ СУЩЕСТВЕННО РАСТИ И СПУСТЯ ДЛИТЕЛЬНОЕ ВРЕМЯ \
      НЕ ПРЕВЫСИТ 50 ГРАДУСОВ, А ПРИ СКВАЖНОСТИ 6 БУДЕТ НЕПРЕРЫВНО РАСТИ И ПРЕВЫСИТ 350 \
      (ДАЛЬШЕ Я НЕ ПРОБОВАЛ, МОЖЕТ ДО ПОЛНОГО ВЫГОРАНИЯ ТЭН, ПОЭТОМУ ВВОДИМ ИСКУСТВЕННУЮ ПАУЗУ, \
      ТАК КАК ДРОБНОЕ ЗНАЧЕНИЕ ШИМ НЕВОЗМОЖНО)

      //НАГРЕВАЕМ ТЭН ПОДАВАЯ ШИМ ЧЕРЕЗ ПАУЗУ (БЕЗ ИСПОЛЬЗОВАНИЯ БИБЛИОТЕКИ ПИД РЕГУЛИРОВАНИЯ)
      if (mill - timer5 > (f.w6 ? 1 : pause)) {
        timer5 = mill; f.w6 = !f.w6;
        (f.w6 ? analogWrite(10, pwm) : digitalWrite(10, LOW));
      }
      //ВЫВОДИМ РЕЗУЛЬТАТЫ НА ЭКРАН КАЖДЫЕ 0,5 СЕК.
      if (mill - timer2 > p500) {
        timer2 = mill;
        lcd.setCursor(4, 0); graf = pwm; digprint3();
        lcd.setCursor(13, 0); graf = testtemp; digprint3();
        lcd.setCursor(11, 1); lcd.print(inputdata); lcd.print(' ');
      }

      //ОБРАБАТЫВАЕМ НАЖАТИЕ НА ЭНКОДЕР ДЛЯ ВЫХОДА ИЗ МЕНЮ
      btn5 = digitalRead(5); if (btn5 != oldbtn5) {
        delay(10); btn5 = digitalRead(5);
        if (!btn5 && oldbtn5) {
          f.w4 = true;
          timer2 = timer2 - p1000;
        } oldbtn5 = btn5;
      }

    }//END MENU 2

  }//END POWER OFF


  ///////////////////////////////////////// EEPROM UPDATE ///////////////////////////////////////////
  if (save == true) {
    //ПЕРЕЗАПИСЫВАЕМ ЗНАЧЕНИЯ В EEPROM ПРИ КАЖДОМ ПЕРЕХОДЕ В РЕЖИМ "POWER OFF"
    temp00 = highByte(temp0); //старший байт
    temp01 = lowByte(temp0); //младший байт
    EEPROM.update(0, temp00); EEPROM.update(1, temp01);
    temp10 = highByte(temp1); temp11 = lowByte(temp1); EEPROM.update(2, temp10); EEPROM.update(3, temp11);
    temp20 = highByte(temp2); temp21 = lowByte(temp2); EEPROM.update(4, temp20); EEPROM.update(5, temp21);
    EEPROM.update(6, tempwait); EEPROM.update(7, led); EEPROM.update(8, sharp); EEPROM.update(9, wait);
    EEPROM.update(10, down); EEPROM.update(11, autoret);
    KpSet10 = highByte(KpSet); KpSet11 = lowByte(KpSet); EEPROM.update(12, KpSet10); EEPROM.update(13, KpSet11);
    KiSet10 = highByte(KiSet); KiSet11 = lowByte(KiSet); EEPROM.update(14, KiSet10); EEPROM.update(15, KiSet11);
    KdSet10 = highByte(KdSet); KdSet11 = lowByte(KdSet); EEPROM.update(16, KdSet10); EEPROM.update(17, KdSet11);
    save = false;
  }

}/////////////////////////////////////////// END LOOP /////////////////////////////////////////////
